ThomasDegallaix/SAGA_internship_2018/work_from_2017/Sprayer_project/pesticides_spreayer_cardboard/cardboard/pesticides_srpeayer_cardboard.kicad_pcb

## KiCad design work_from_2017/Sprayer_project/pesticides_spreayer_cardboard/cardboard/pesticides_srpeayer_cardboard.kicad_pcb (2018-05-15)

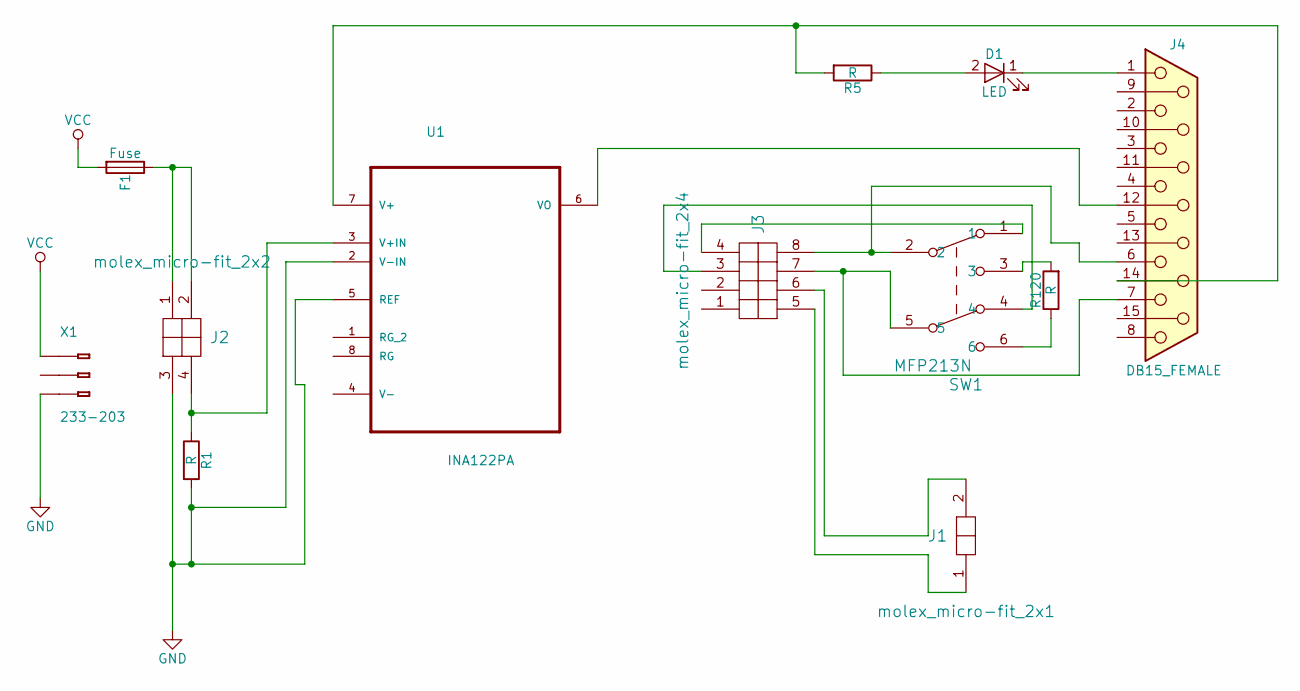
[picture p1: schematic pesticides_srpeayer_cardboard.sch]

Parts:
D1: LED; LED_D3.0mm
F1: Fuse; Fuseholder_ATO_Blade_littlefuse_Pudenz_2_Pin
J1: molex_micro-fit_2x1; molex_micro-fit_43045-0212
J2: molex_micro-fit_2x2; molex_micro-fit_43045-0412
J3: molex_micro-fit_2x4; molex_micro-fit_43045-0812
J4: DB15_FEMALE; DB15FC
R1, R5, R120: R; R_Axial_DIN0207_L6.3mm_D2.5mm_P10.16mm_Horizontal
SW1: MFP213N; MFP213N_DPDT
U1: INA122PA; DIP254P762X508-8
X1: 233-203

Connections:
GND: J2.3, R1.2, U1.2 (V-IN), U1.5 (REF), X1.B3 (B-3)
unnamed: D1.1 (K), J4.1
unnamed: D1.2 (A), R5.1
unnamed: F1.1, J2.1, J2.2
unnamed: J1.1, J3.5
unnamed: J1.2, J3.6
unnamed: J2.4, R1.1, U1.3 (V+IN)
unnamed: J3.3, SW1.4
unnamed: J3.4, SW1.1
unnamed: J3.7, J4.7, SW1.5
unnamed: J3.8, J4.6, SW1.2
unnamed: J4.12, U1.6 (VO)
unnamed: J4.14, R5.2, U1.7 (V+)
unnamed: R120.1, SW1.6
unnamed: R120.2, SW1.3
VCC: F1.2, X1.B1 (B-1)

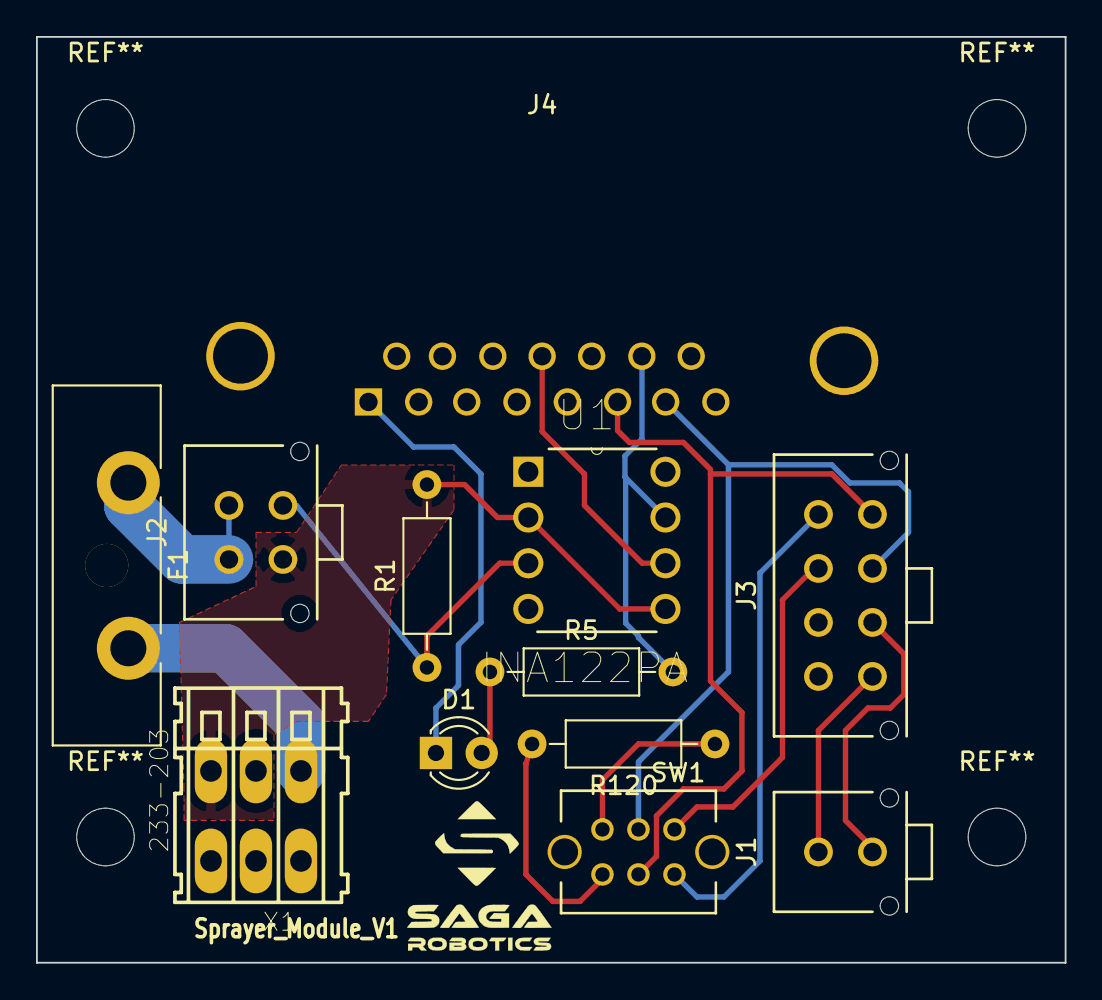
[picture p2: board pesticides_srpeayer_cardboard.kicad_pcb from above]

Board: 2 copper layers, 57.1 x 51.4 mm, 12 parts (0 on the bottom side), 16 nets.
