ThomasDegallaix/SAGA_internship_2018/(commit log)

2018-05-23 SprayerV3: switch from global a variable for the request to a struct
2018-05-23 Name changed
    [pesticides_spreayer_cardboard-B.Cu.gbr, pesticides_spreayer_cardboard-B.Mask.gbr, pesticides_spreayer_cardboard-B.SilkS.gbr, pesticides_spreayer_cardboard-Edge.Cuts.gbr, pesticides_spreayer_cardboard-F.Cu.gbr, pesticides_spreayer_cardboard-F.Mask.gbr, pesticides_spreayer_cardboard-F.SilkS.gbr, pesticides_spreayer_cardboard-NPTH.drl]
2018-05-25 SprayerV5 uses now the correct msg datatype + beginning of pressure enslavement
2018-05-29 New version of the sprayer pump script.
2018-05-30 sprayer_controller service pay attention to the pump status
2018-06-05 Rate changement (1Hz to 10 Hz)
2018-06-06 Retrieve pressure in sprayerV5
2018-06-06 SprayerV6: Use of the flow and tora's velocity
2018-06-21 More datasheets
    [pesticides_srpeayer_cardboard.kicad_pcb, pesticides_srpeayer_cardboard.sch]
